dario0603/AB-class-amplifier/README.md

# Class-AB Audio Power Amplifier

<p align="left">
  
  
  
</p>

## Overview

Design and simulation of a **Class-AB audio power amplifier**, focusing on output-stage linearity, crossover distortion reduction, and overcurrent protection.

The circuit combines an input amplification stage, diode-based biasing, and a complementary power output stage to achieve linear signal amplification. LTspice simulations are used to investigate the amplifier's transient response, frequency behavior, and current-limiting operation.

The project also explores the interaction between output-stage biasing, load current, and protection circuitry.

## Design Calculations

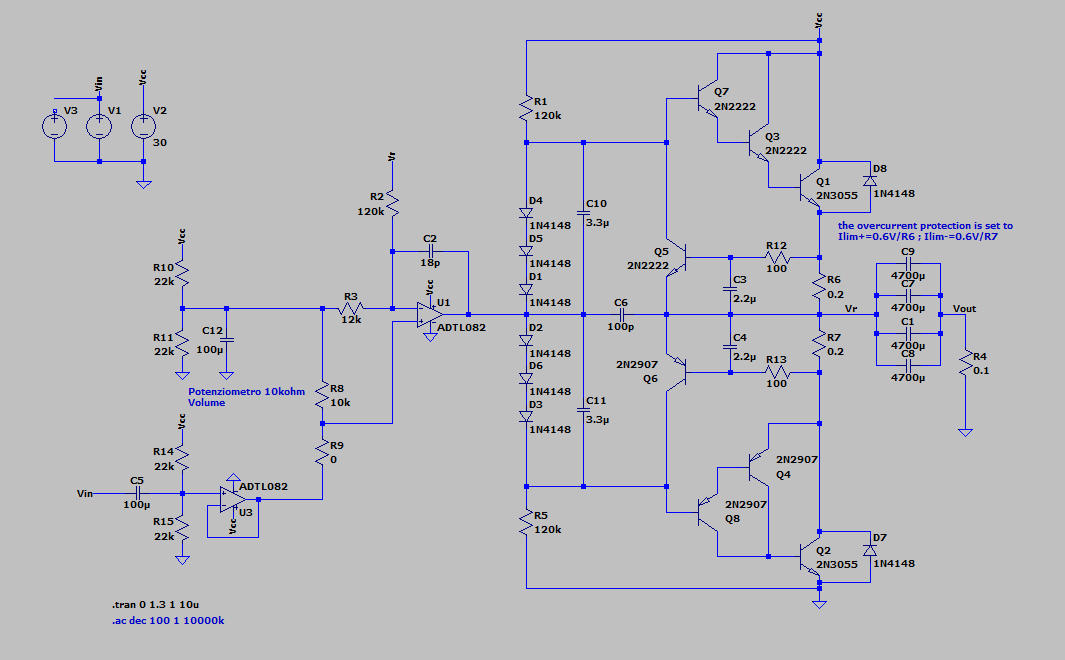
[picture p1: img/LtSpice-schematic.png]
LTspice schematic of the Class-AB audio power amplifier


### 1. Power-Supply Smoothing Capacitor

The required smoothing capacitance is estimated using the empirical relationship for a full-wave rectifier:

$$
C \simeq \frac{I_{\mathrm{load}}}{2f \cdot \Delta V}
$$

where:
- $I_{\mathrm{load}}$ is the maximum load current.
- $f$ is the AC supply frequency.
- $\Delta V$ is the maximum allowable peak-to-peak ripple voltage.

Assuming a maximum load current of 3A, limited by the BJT-based output protection circuit, and a maximum ripple voltage of 2V, the required capacitance is approximately 15mF, assuming a 50Hz AC supply.

The implemented solution uses five 4700 $\mu$F capacitors connected in parallel, providing a nominal total capacitance of:

$$
C_{\mathrm{total}} = 5 \times 4700\mu\mathrm{F}
= 23.5\mathrm{mF}
$$

This capacitance exceeds the theoretical minimum and provides additional margin for smoothing the rectified voltage under load.

### 2. Output Current-Limit Protection

The positive and negative output-current limits are set by the current-sensing resistors $R_6$ and $R_7$. Using the approximate base-emitter voltage of a BJT, $V_{BE}\simeq 0.6\mathrm{V}$, the limiting currents can be estimated as:

$$
I_{\mathrm{max}+} \simeq \frac{0.6\mathrm{V}}{R_6}
$$

$$
I_{\mathrm{max}-} \simeq -\frac{0.6\mathrm{V}}{R_7}
$$

For a nominal current limit of approximately $\pm 3\mathrm{A}$, the required resistance values are:

$$
R_6 \simeq R_7 \simeq
\frac{0.6\mathrm{V}}{3\mathrm{A}}
= 0.2\Omega
$$

Using equal sensing resistances provides approximately symmetrical positive and negative current limits. The actual thresholds may differ due to transistor characteristics, temperature, and resistor tolerances.

### 3. Volume Control

Resistors $R_8$ and $R_9$ represent the upper and lower portions of a $10\mathrm{k}\Omega$ potentiometer used to adjust the amplifier's input level.

Rotating the potentiometer changes the voltage delivered to the following amplification stage, thereby controlling the audio volume.

### 4. Output power

Provided that overcurrent limiting is not triggered (i.e., the current remains below 3 A in magnitude), the maximum output voltage is given by \(V_{\mathrm{CC}} - 2V_{\gamma} - V_{\mathrm{ripple}}\). With a 32 V supply, this is approximately

$$
V_{\mathrm{out,max}} \simeq 32\mathrm{V} - 1.2\mathrm{V} - 2\mathrm{V} \simeq 28.8\mathrm{V}
$$

Considering the output voltage swing limitations of the TL082 operational amplifiers, whose maximum output voltage is approximately $V_{\mathrm{CC}} - 1.5\mathrm{V}$ and whose minimum output voltage is approximately \(1.5\mathrm{V}\), the maximum voltage swing is

$$
V_{\mathrm{pp}} \simeq 28.8\mathrm{V} - 1.5\mathrm{V} - 1.5\mathrm{V} \simeq 25.8\mathrm{V}
$$

Assuming a sinusoidal output signal, the maximum output power can be estimated as

$$
P_{\mathrm{out}} = \frac{V_{\mathrm{pp}}^2}{8R_{\mathrm{load}}}
$$

For a $4\Omega$ load, the maximum output power is approximately

$$
P_{\mathrm{out}} = \frac{25.8^2}{8 \cdot 4} \approx 20.8\,\mathrm{W}
$$

For an $8\Omega$ load, the maximum output power is approximately

$$
P_{\mathrm{out}} = \frac{25.8^2}{8 \cdot 8} \approx 10.4\mathrm{W}
$$

To increase the output power, the supply voltage $V\_{\mathrm{CC}}$ must be increased, while ensuring that the maximum supply voltage rating of the TL082 operational amplifiers is not exceeded.

## Simulation Results

### 1. Transient Response

The transient simulation compares the input signal $V_{in}$ with the output signal $V_{out}$.

The output waveform demonstrates the amplifier's ability to reproduce the input sinusoid with increased amplitude. The region around the zero crossing is particularly relevant for evaluating crossover distortion in the Class-AB output stage.

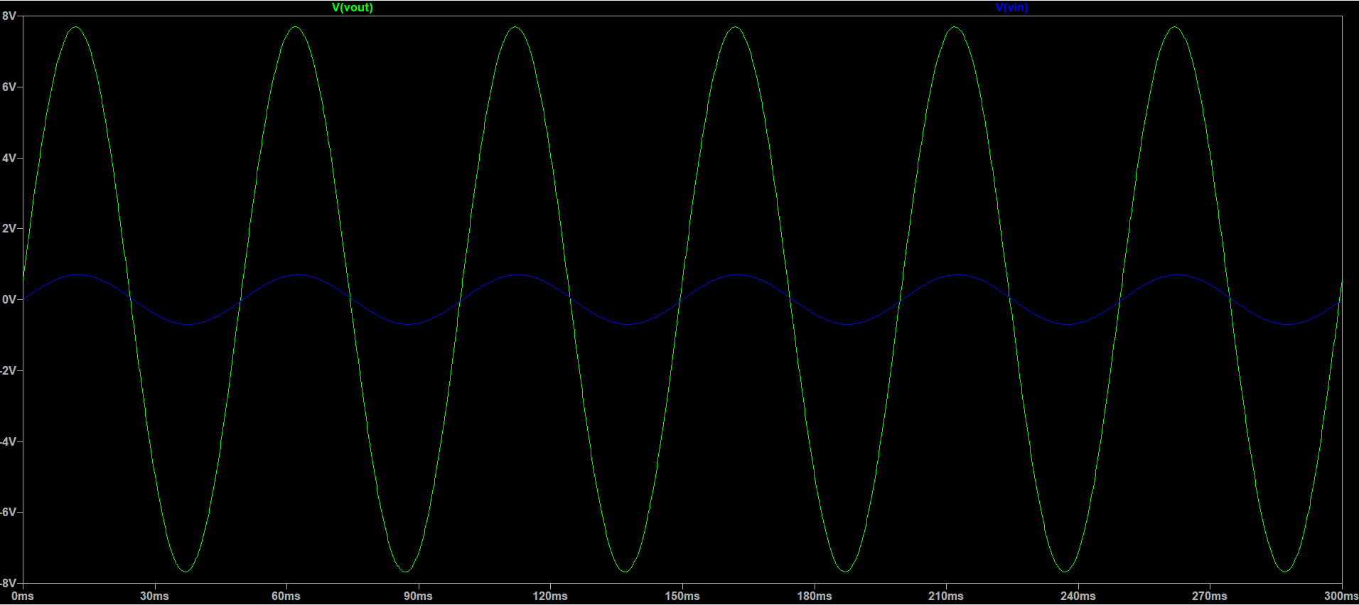
[picture p2: img/Sinusoidal-response.png]
Sinusoidal transient response


### 2. Frequency Response

The Bode plot shows the output-to-input transfer function in terms of gain magnitude and phase.

The simulated response exhibits a relatively flat passband up to approximately **100 kHz**, followed by high-frequency attenuation. The magnitude and phase responses provide insight into the amplifier's bandwidth and frequency-dependent behavior.

The voltage gain is set to the maximum value for this configuration, $A_v = 11 \simeq 20.8\text{dB}$.

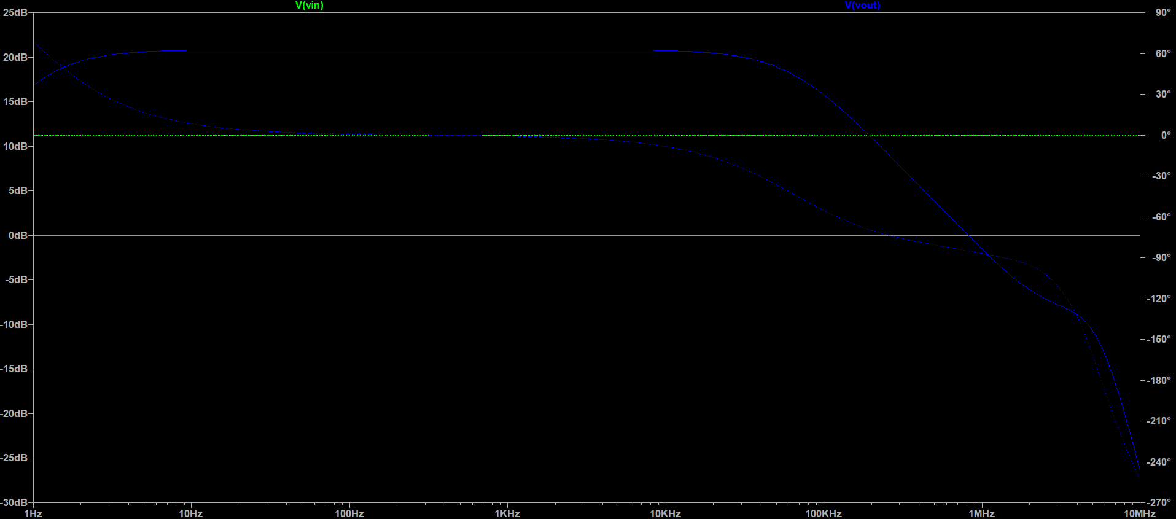
[picture p3: img/Bode-diagram.png]
Bode plot of the amplifier


### 3. Output Current Limiting

The current-limit simulation evaluates the behavior of the protection circuit under excessive output-current demand.

The circuit is designed to constrain the load current to approximately **±3 A**, helping protect the output transistors against overload conditions.

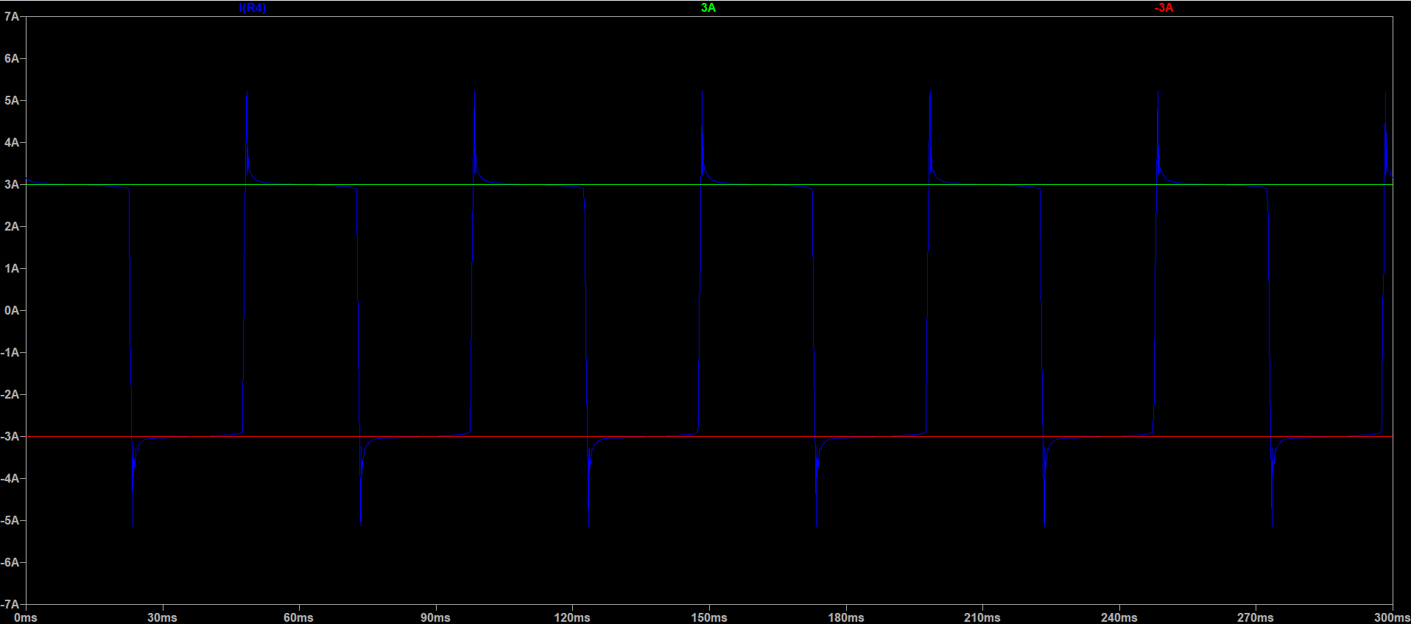
[picture p4: img/Current-limit-protection.png]
Output current limiting simulation


### 4. Current-Limit Transient Response

A closer view of the transient response highlights the behavior of the protection circuit during a current-limit event.

The simulation shows the current transient settling toward the intended limiting level. The observed settling time is approximately **12 ms** under the simulated conditions.

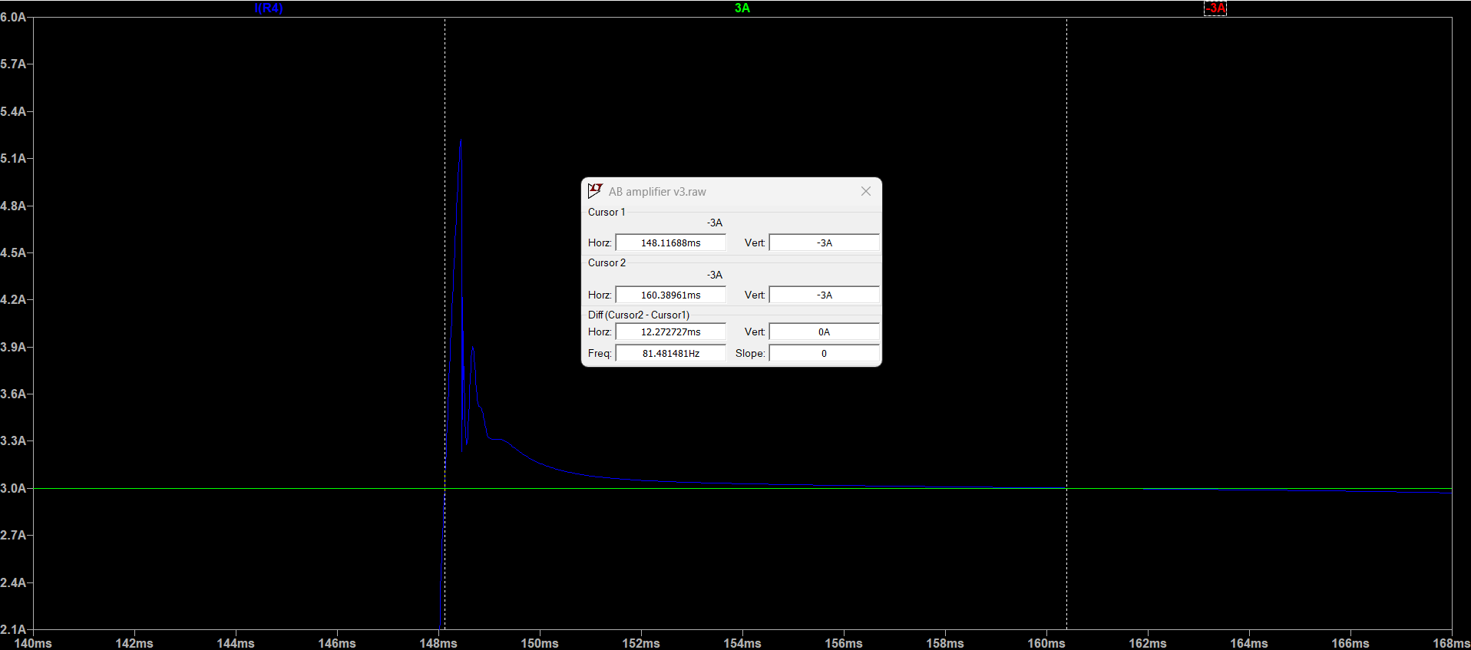
[picture p5: img/Current-limit-protection-transient.png]
Transient response of the current-limit protection


## PCB Design

The PCB layout was developed in KiCad based on the Class-AB audio power amplifier schematic. Particular attention was paid to component placement, power-stage routing, and current-carrying traces to ensure reliable operation.

The PCB design aims to minimize unwanted parasitic effects and provide suitable routing for the relatively high currents handled by the output stage. The placement of the output transistors and current-sensing resistors is particularly important for thermal management and current-limit protection.

### 1. PCB Layout

The following image shows the PCB layout designed in KiCad, including component placement and routing.

<p align="center">
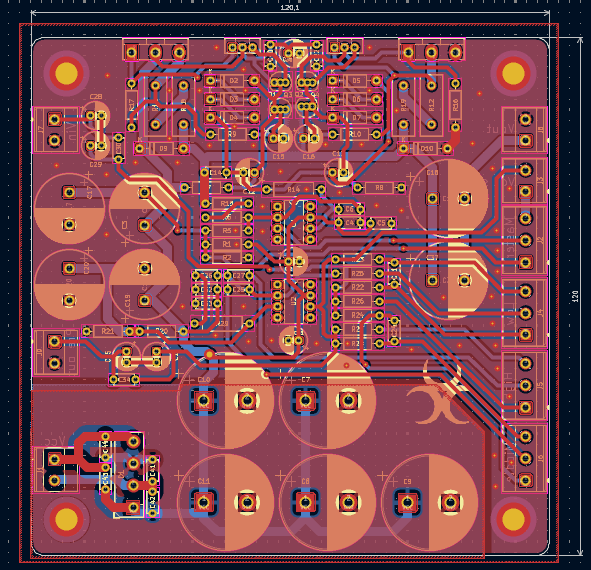
[picture p6: img/PCB_design.png]
PCB layout of the Class-AB audio power amplifier
  
</p>

### 2. 3D PCB View

The 3D visualization provides a preview of the assembled PCB, showing the component placement and overall board layout. This view is useful for inspecting component positioning and evaluating the physical arrangement before manufacturing.

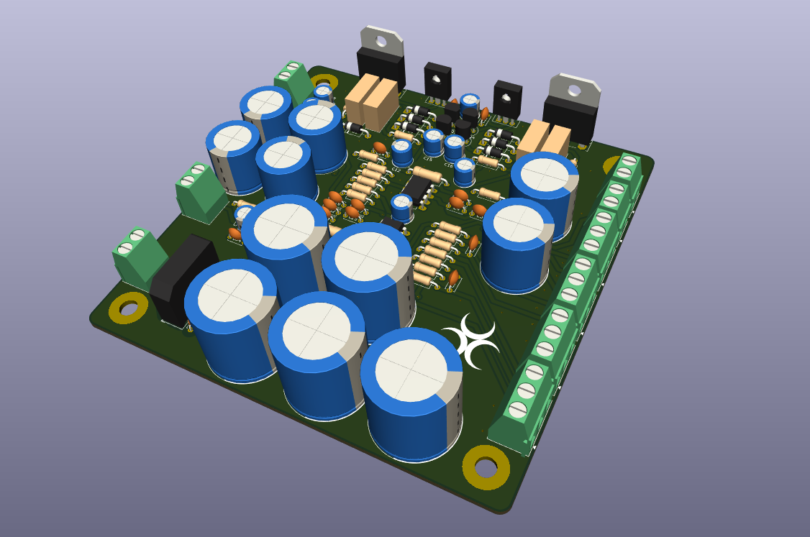
[picture p7: img/3D_PCB_design.png]
3D view of the Class-AB audio power amplifier PCB


## Repository Structure

```text
.
├── README.md                               # Project documentation
├── img/                                    # Images and simulation results
├── KiCad/                                  # Schematics and PCB designs
│   └── mono_amplifier/
│       ├── AB_amp/                         # Class-AB amplifier design
│       ├── audio equalizer/                # Audio equalizer design
│       ├── mono_amplifier/                 # Main KiCad project — open this project only;
│       │                                   # the other designs are internally linked
│       └── power supply/                   # Power supply design
└── Spice/                                  # LTspice simulations
    └── opamp version/
        ├── AB amplifier final version.asc  # Final amplifier simulation
        ├── AB amplifier v1.asc             # Amplifier simulation, version 1
        ├── AB amplifier v2.asc             # Amplifier simulation, version 2
        └── AB amplifier v3.asc             # Amplifier simulation, version 3
```

> **Important:** Open only the main KiCad project file: `KiCad/mono_amplifier/mono_amplifier/mono_amplifier.kicad_pro`. The other KiCad designs are internally linked to this project.
