dario0603/AB-class-amplifier/Spice/opamp version/AB amplifier v3.asc

C1: cap; 4700µ
C2: cap; 18p
C3: cap; 2.2µ
C4: cap; 2.2µ
C5: cap; 100µ
C6: cap; 100p
C7: cap; 4700µ
C8: cap; 4700µ
C9: cap; 4700µ
C10: cap; 3.3µ
C11: cap; 3.3µ
C12: cap; 100µ
D1: diode; 1N4148
D2: diode; 1N4148
D3: diode; 1N4148
D4: diode; 1N4148
D5: diode; 1N4148
D6: diode; 1N4148
D7: diode; 1N4148
D8: diode; 1N4148
Q1: npn; 2N3055
Q2: npn; 2N3055
Q3: npn; 2N2222
Q4: pnp; 2N2907
Q5: npn; 2N2222
Q6: pnp; 2N2907
Q7: npn; 2N2222
Q8: pnp; 2N2907
R1: res; 120k
R2: res; 120k
R3: res; 12k
R4: res; 8
R5: res; 120k
R6: res; 0.2
R7: res; 0.2
R8: res; 10k
R9: res; 0
R10: res; 22k
R11: res; 22k
R12: res; 100
R13: res; 100
R14: res; 22k
R15: res; 22k
U1: ADTL082
U3: ADTL082
V1: voltage; SINE(0 0.7 20); AC 1 0
V2: voltage; 30
V3: voltage; PWL(0 0 1m 0 10m 5); AC 0 0
Named nets: Vcc, Vr, Vout, 0, Vin
.tran 0 1.3 1 10u
.ac dec 100 1 10000k
the overcurrent protection is set to
Ilim+=0.6V/R6 ; Ilim-=0.6V/R7
Potenziometro 10kohm
Volume
