dario0603/AB-class-amplifier/Spice/opamp version/AB amplifier final version.asc

C1: cap; 4700µ
C2: cap; 10µ
C3: cap; 2.2µ
C4: cap; 2.2µ
C5: cap; 10µ
C6: cap; 100p
C7: cap; 4700µ
C8: cap; 4700µ
C9: cap; 4700µ
C10: cap; 4700µ
C11: cap; 4700µ
C12: cap; 4700µ
C13: cap; 4700µ
C14: cap; 4.7p
C15: cap; 3.3µ
C16: cap; 4700µ
C17: cap; 3.3µ
D1: diode; 1N4148
D2: diode; 1N4148
D3: diode; 1N4148
D4: diode; 1N4148
D5: diode; 1N4148
D6: diode; 1N4148
D7: diode; 1N4148
D8: diode; 1N4148
D9: diode; 1N4148
D10: diode; 1N4148
D11: diode; 1N4148
D12: diode; 1N4148
Q1: npn; 2N3055
Q2: npn; 2N3055
Q3: npn; 2N2222
Q4: pnp; 2N2907
Q5: npn; 2N2222
Q6: pnp; 2N2907
Q7: npn; 2N2222
Q8: pnp; 2N2907
R1: res; 12k
R2: res; 180k
R3: res; 12k
R4: res; 4
R5: res; 12k
R6: res; 0.2
R7: res; 0.2
R8: res; 5k
R9: res; 0
R10: res; 22k
R11: res; 22k
R12: res; 100
R13: res; 100
R14: res; 22k
R15: res; 22k
U1: ADTL082
U3: ADTL082
V1: voltage; SINE(0 0.7 20k 2); AC 1 0
V2: voltage; SINE(0 36 50)
Named nets: Vcc, Vr, Vout, 0, Vin
.tran 0 2.001 2 10u
.ac dec 100 1 10000k
the overcurrent protection is set to
Ilim+=0.6V/R6 ; Ilim-=0.6V/R7
Potenziometro 10kohm
Volume
