dario0603/AB-class-amplifier/KiCad/mono_amplifier/mono_amplifier/mono_amplifier.kicad_pcb

## KiCad design KiCad/mono_amplifier/mono_amplifier/mono_amplifier.kicad_pcb (2026-09-21)

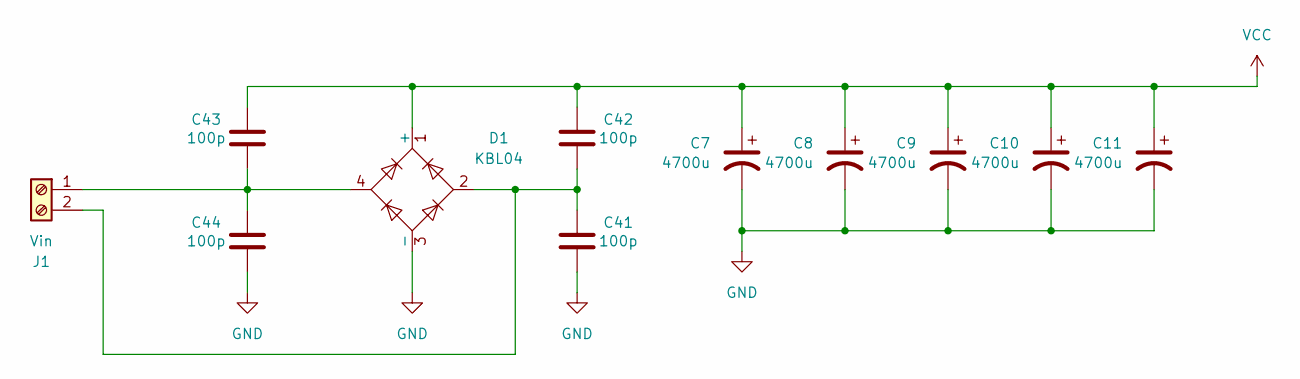
[picture p8: schematic power supply.kicad_sch]

Parts:
C7, C8, C9, C10, C11: 4700u; CP_Radial_D22.0mm_P10.00mm_SnapIn
C41, C42, C43, C44: 100p; C_Disc_D4.7mm_W2.5mm_P5.00mm
D1: KBL04; Diode_Bridge_Vishay_KBL
J1: Vin; TerminalBlock_Phoenix_MKDS-1,5-2_1x02_P5.00mm_Horizontal

Connections:
GND: C7.2, C8.2, C9.2, C10.2, C11.2, C41.2, C44.2, D1.3 (-); also elsewhere on the board
unnamed: C43.2, C44.1, D1.4, J1.1
unnamed: C41.1, C42.2, D1.2, J1.2
VCC: C7.1, C8.1, C9.1, C10.1, C11.1, C42.1, C43.1, D1.1 (+); also elsewhere on the board

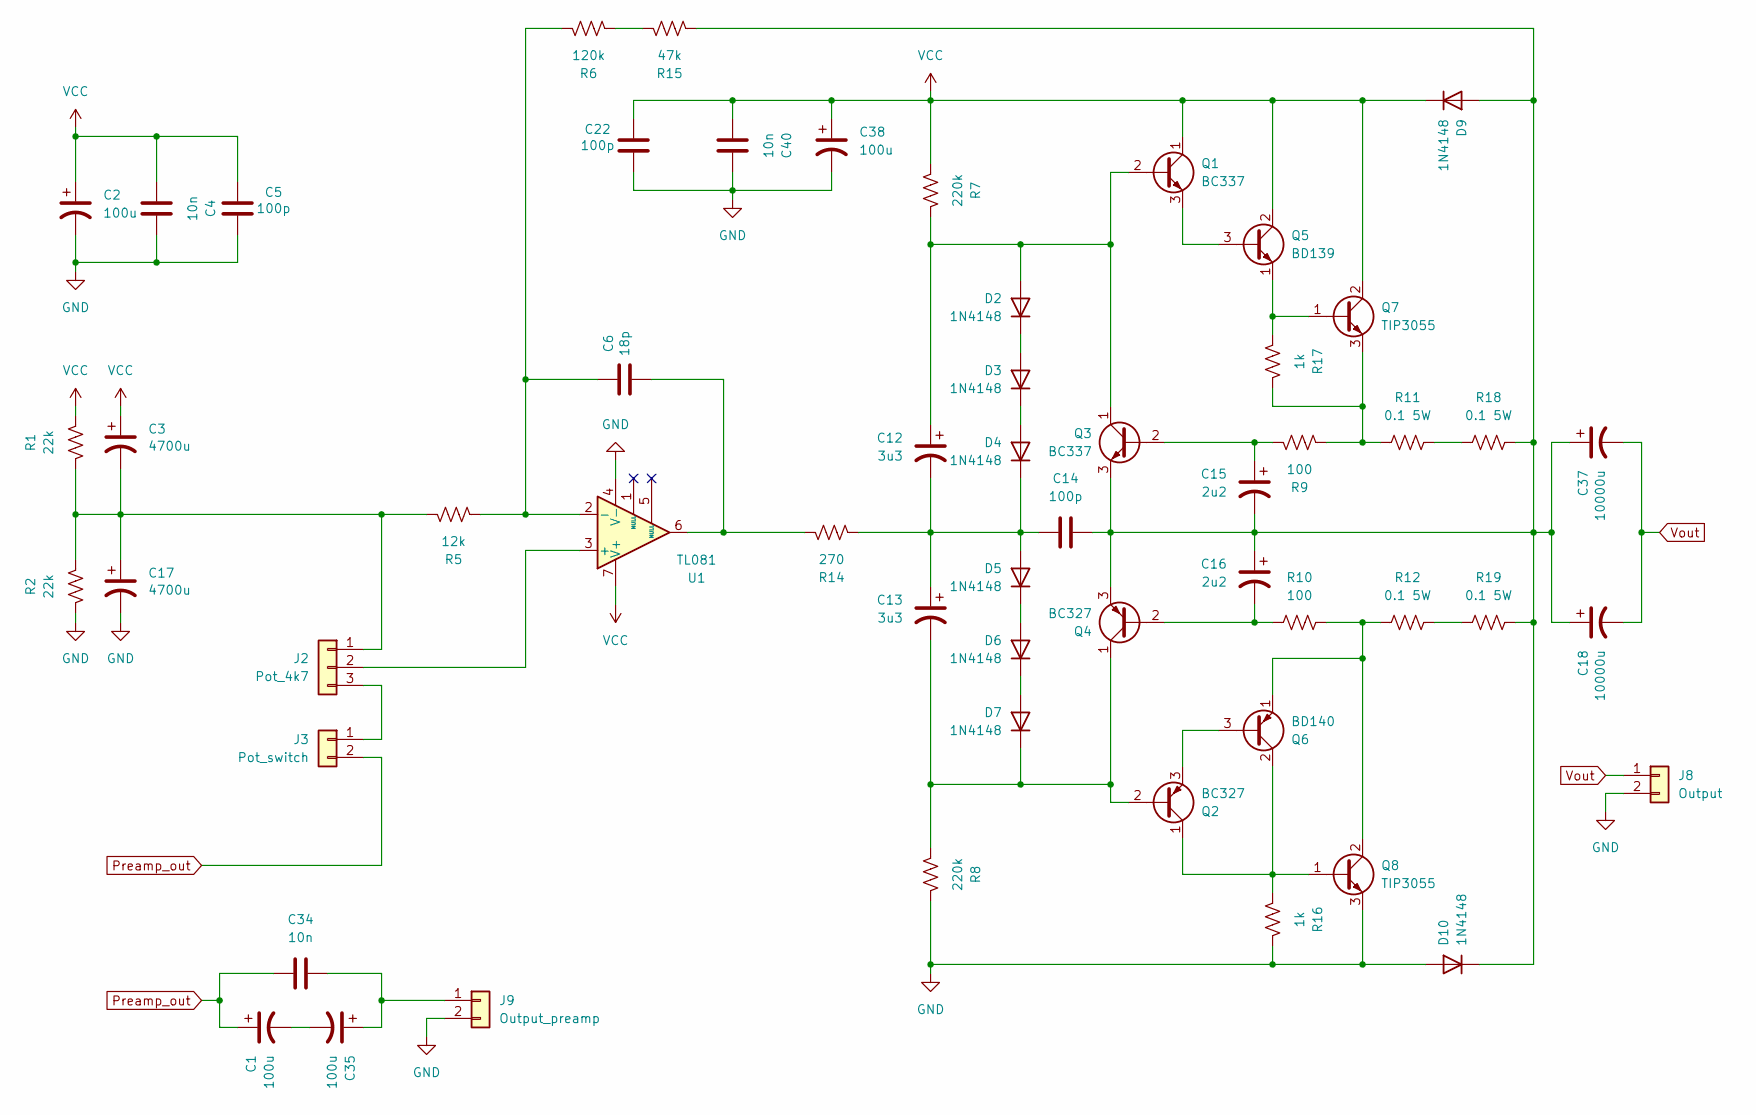
[picture p9: schematic AB_amp.kicad_sch]

Parts:
C1, C2, C35, C38: 100u; CP_Radial_D6.3mm_P2.50mm
C3, C17: 4700u; CP_Radial_D16.0mm_P7.50mm
C4, C34, C40: 10n; C_Disc_D4.7mm_W2.5mm_P5.00mm
C5, C14, C22: 100p; C_Disc_D4.7mm_W2.5mm_P5.00mm
C6: 18p; C_Disc_D4.7mm_W2.5mm_P5.00mm
C12, C13: 3u3; CP_Radial_D6.3mm_P2.50mm
C15, C16: 2u2; CP_Radial_D6.3mm_P2.50mm
C18, C37: 10000u; CP_Radial_D18.0mm_P7.50mm
D2, D3, D4, D5, D6, D7, D9, D10: 1N4148; D_DO-41_SOD81_P10.16mm_Horizontal
J2: Pot_4k7; TerminalBlock_Phoenix_MKDS-1,5-3-5.08_1x03_P5.08mm_Horizont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
J3: Pot_switch; TerminalBlock_Phoenix_MKDS-1,5-2_1x02_P5.00mm_Horizontal
J8: Output; TerminalBlock_Phoenix_MKDS-1,5-2_1x02_P5.00mm_Horizontal
J9: Output_preamp; TerminalBlock_Phoenix_MKDS-1,5-2_1x02_P5.00mm_Horizontal
Q1, Q3: BC337; TO-92_Inline
Q2, Q4: BC327; TO-92_Inline
Q5: BD139; TO-126-3_Vertical
Q6: BD140; TO-126-3_Vertical
Q7, Q8: TIP3055; TO-218-3_Vertical
R1, R2: 22k; R_Axial_DIN0207_L6.3mm_D2.5mm_P10.16mm_Horizontal
R5: 12k; R_Axial_DIN0207_L6.3mm_D2.5mm_P10.16mm_Horizontal
R6: 120k; R_Axial_DIN0207_L6.3mm_D2.5mm_P10.16mm_Horizontal
R7, R8: 220k; R_Axial_DIN0207_L6.3mm_D2.5mm_P10.16mm_Horizontal
R9, R10: 100; R_Axial_DIN0207_L6.3mm_D2.5mm_P10.16mm_Horizontal
R11, R12, R18, R19: 0.1 5W; R_Box_L14.0mm_W5.0mm_P9.00mm
R14: 270; R_Axial_DIN0309_L9.0mm_D3.2mm_P12.70mm_Horizontal
R15: 47k; R_Axial_DIN0207_L6.3mm_D2.5mm_P10.16mm_Horizontal
R16, R17: 1k; R_Axial_DIN0207_L6.3mm_D2.5mm_P10.16mm_Horizontal
U1: TL081; DIP-8_W7.62mm_LongPads

Connections:
GND: C2.2, C4.2, C5.2, C17.2, C22.2, C38.2, C40.2, D10.2 (A), J8.2, J9.2, Q8.3 (E), R2.2, R8.1, R16.1, U1.4 (V-); also elsewhere on the board
unnamed: C1.2, C35.2
unnamed: C6.2, R14.1, U1.6
unnamed: C12.1, D2.2 (A), Q1.2 (B), Q3.1 (C), R7.1
unnamed: D2.1 (K), D3.2 (A)
unnamed: D3.1 (K), D4.2 (A)
unnamed: C12.2, C13.1, C14.1, D4.1 (K), D5.2 (A), R14.2
unnamed: D5.1 (K), D6.2 (A)
unnamed: D6.1 (K), D7.2 (A)
unnamed: C13.2, D7.1 (K), Q2.2 (B), Q4.1 (C), R8.2
unnamed: C14.2, C15.2, C16.1, C18.1, C37.1, D9.2 (A), D10.1 (K), Q3.3 (E), Q4.3 (E), R15.2, R18.2, R19.2
unnamed: C3.2, C17.1, J2.1, R1.2, R2.1, R5.1
unnamed: J2.2, U1.3 (+)
unnamed: J2.3, J3.1
unnamed: C34.2, C35.1, J9.1
unnamed: Q1.3 (E), Q5.3 (B)
unnamed: Q2.1 (C), Q6.2 (C), Q8.1 (B), R16.2
unnamed: Q2.3 (E), Q6.3 (B)
unnamed: C15.1, Q3.2 (B), R9.1
unnamed: C16.2, Q4.2 (B), R10.1
unnamed: Q5.1 (E), Q7.1 (B), R17.2
unnamed: Q6.1 (E), Q8.2 (C), R10.2, R12.1
unnamed: Q7.3 (E), R9.2, R11.1, R17.1
unnamed: R11.2, R18.1
unnamed: R12.2, R19.1
unnamed: R6.2, R15.1
unnamed: C6.1, R5.2, R6.1, U1.2 (-)
Preamp_out: C1.1, C34.1, J3.2; also elsewhere on the board
VCC: C2.1, C3.1, C4.1, C5.1, C22.1, C38.1, C40.1, D9.1 (K), Q1.1 (C), Q5.2 (C), Q7.2 (C), R1.1, R7.2, U1.7 (V+); also elsewhere on the board
Vout: C18.2, C37.2, J8.1

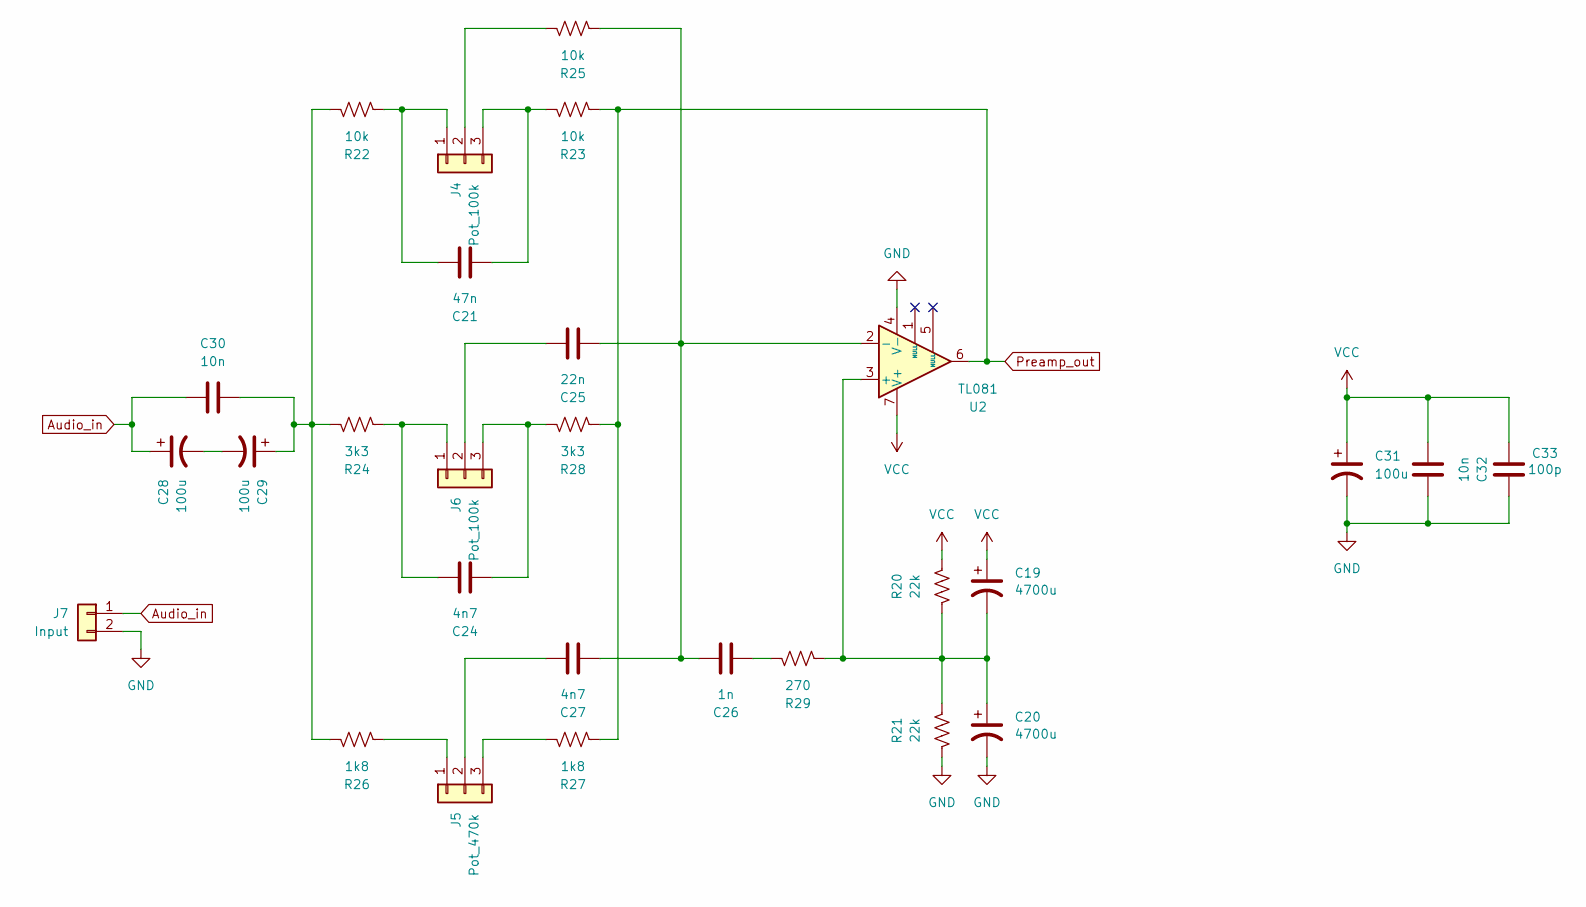
[picture p10: schematic audio equalizer.kicad_sch]

Parts:
C19, C20: 4700u; CP_Radial_D16.0mm_P7.50mm
C21: 47n; C_Disc_D4.7mm_W2.5mm_P5.00mm
C24, C27: 4n7; C_Disc_D4.7mm_W2.5mm_P5.00mm
C25: 22n; C_Disc_D4.7mm_W2.5mm_P5.00mm
C26: 1n; C_Disc_D4.7mm_W2.5mm_P5.00mm
C28, C29, C31: 100u; CP_Radial_D6.3mm_P2.50mm
C30, C32: 10n; C_Disc_D4.7mm_W2.5mm_P5.00mm
C33: 100p; C_Disc_D4.7mm_W2.5mm_P5.00mm
J4, J6: Pot_100k; TerminalBlock_Phoenix_MKDS-1,5-3-5.08_1x03_P5.08mm_Horizont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
J5: Pot_470k; TerminalBlock_Phoenix_MKDS-1,5-3-5.08_1x03_P5.08mm_Horizont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
J7: Input; TerminalBlock_Phoenix_MKDS-1,5-2_1x02_P5.00mm_Horizontal
R20, R21: 22k; R_Axial_DIN0207_L6.3mm_D2.5mm_P10.16mm_Horizontal
R22, R23, R25: 10k; R_Axial_DIN0207_L6.3mm_D2.5mm_P10.16mm_Horizontal
R24, R28: 3k3; R_Axial_DIN0207_L6.3mm_D2.5mm_P10.16mm_Horizontal
R26, R27: 1k8; R_Axial_DIN0207_L6.3mm_D2.5mm_P10.16mm_Horizontal
R29: 270; R_Axial_DIN0309_L9.0mm_D3.2mm_P12.70mm_Horizontal
U2: TL081; DIP-8_W7.62mm_LongPads

Connections:
Audio_in: C28.1, C30.1, J7.1
GND: C20.2, C31.2, C32.2, C33.2, J7.2, R21.2, U2.4 (V-); also elsewhere on the board
unnamed: C26.2, R29.1
unnamed: C28.2, C29.2
unnamed: C29.1, C30.2, R22.1, R24.1, R26.1
unnamed: C21.1, J4.1, R22.2
unnamed: J4.2, R25.1
unnamed: C21.2, J4.3, R23.1
unnamed: J5.1, R26.2
unnamed: C27.1, J5.2
unnamed: J5.3, R27.1
unnamed: C24.1, J6.1, R24.2
unnamed: C25.1, J6.2
unnamed: C24.2, J6.3, R28.1
unnamed: C19.2, C20.1, R20.2, R21.1, R29.2, U2.3 (+)
unnamed: C25.2, C26.1, C27.2, R25.2, U2.2 (-)
Preamp_out: R23.2, R27.2, R28.2, U2.6; also elsewhere on the board
VCC: C19.1, C31.1, C32.1, C33.1, R20.1, U2.7 (V+); also elsewhere on the board

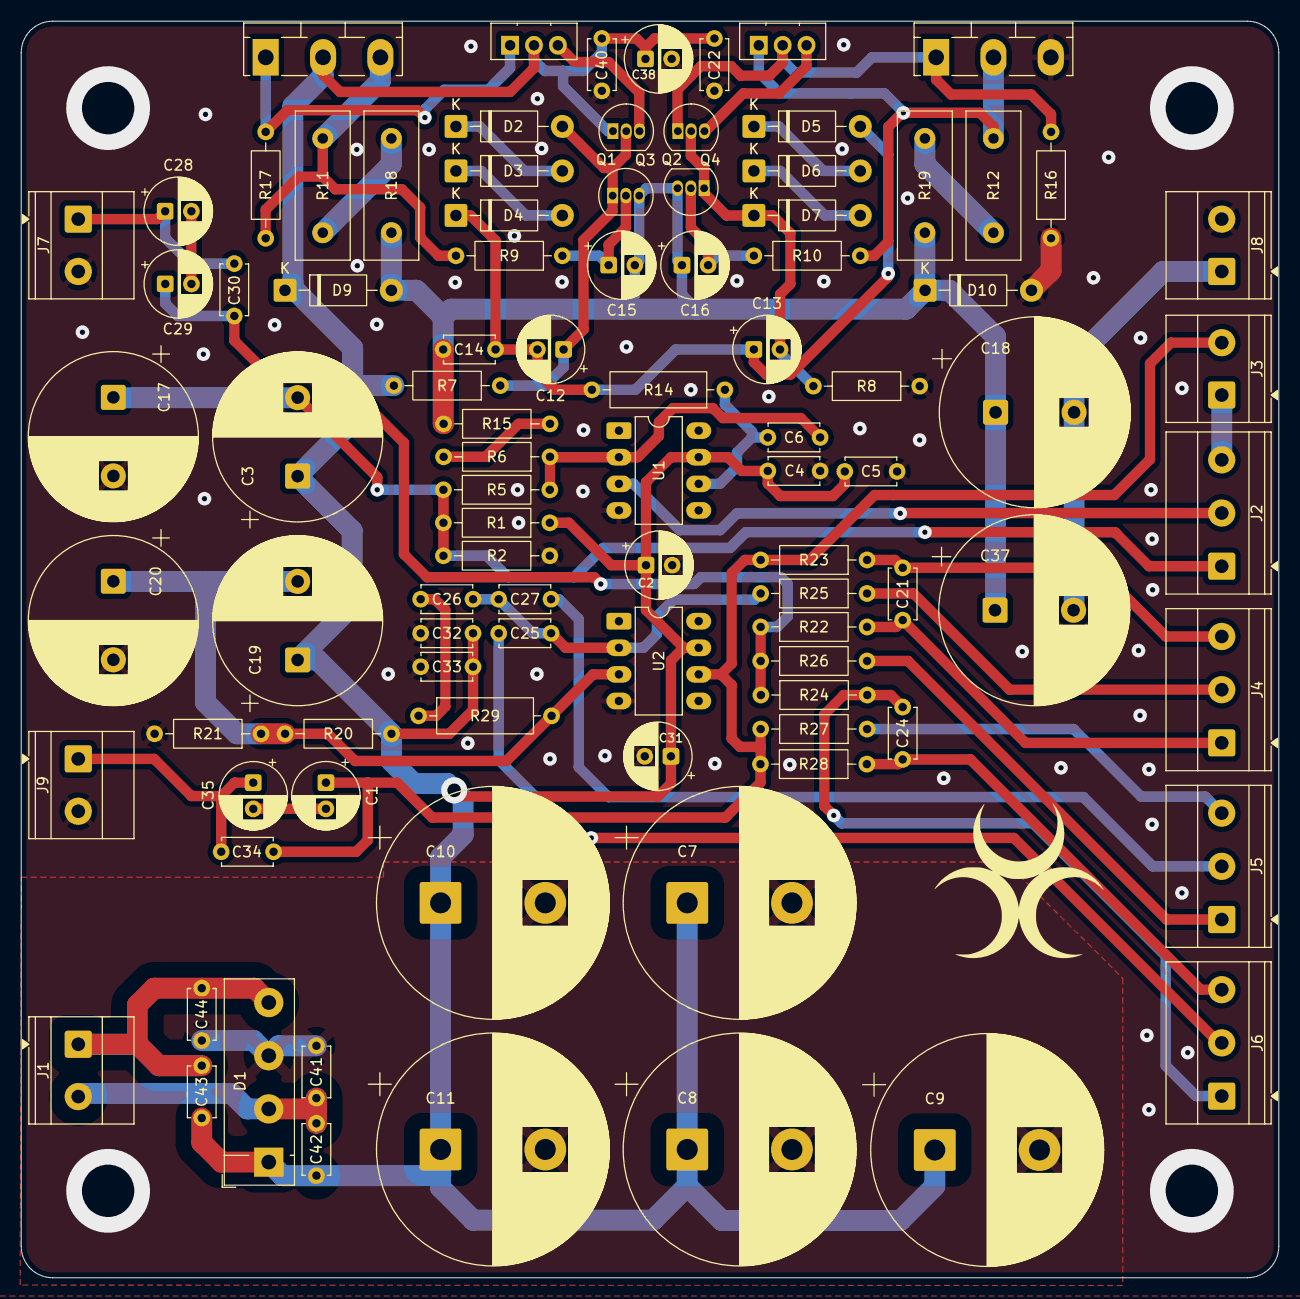
[picture p11: board mono_amplifier.kicad_pcb from above]

Board: 2 copper layers, 120.1 x 120.0 mm, 95 parts (0 on the bottom side), 47 nets.
