dario0603/AB-class-amplifier/(commit log)

2026-10-19 README.md updated
    [AB_amp.kicad_pcb, AB_amp.kicad_sch, audio equalizer.kicad_pcb, audio equalizer.kicad_sch, power supply.kicad_pcb, power supply.kicad_sch, speaker protection.kicad_pcb, speaker protection.kicad_sch]
2026-10-19 added PCB design
2026-10-19 Change PCB layout image to HTML format
    Updated PCB layout image format in README.md to use HTML for centering.
